sudodevjay/esp32p10display/ftdiuarttottl.png

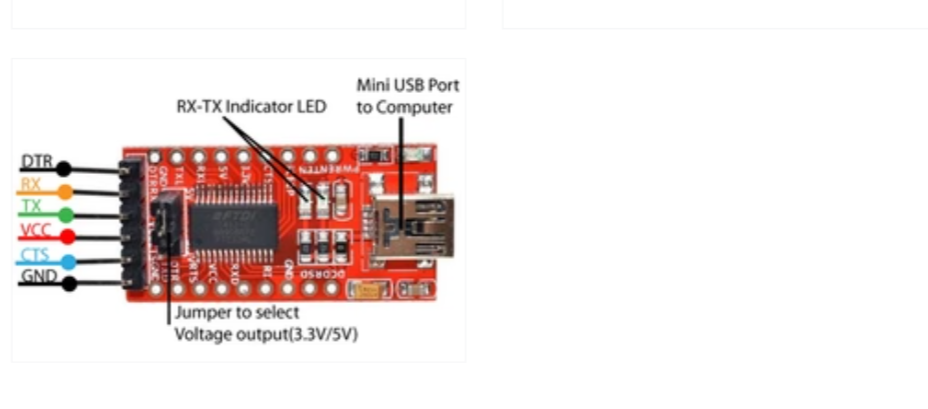
ftdiuarttottl.png
