sudodevjay/esp32p10display/Project Outputs for esp32p10displayProject/Reports/esp32p10displayPCB1.html

Altium

# Design Rule Verification Report

Date: | | 23-10-2026
Time: | | 10:41:11
Elapsed Time: | | 00:00:02
Filename: | | C:\Users\Public\Documents\Altium\esp32p10displayProject\esp32p10displayPCB1.PcbDoc

Warnings: | | 0
Rule Violations: | | 45

## Summary

Warnings | Count
Total | 0

Rule Violations | Count
Clearance Constraint (Gap=10mil) (All),(All) | 0
Clearance Constraint (Gap=8mil) (InComponent('U7')),(InComponent('U7')) | 0
Short-Circuit Constraint (Allowed=No) (All),(All) | 0
Un-Routed Net Constraint ( (All) ) | 0
Modified Polygon (Allow modified: No), (Allow shelved: No) | 0
Width Constraint (Min=6mil) (Max=50mil) (Preferred=10mil) (All) | 0
Routing Topology Rule(Topology=Shortest) (All) | 0
Power Plane Connect Rule(Relief Connect )(Expansion=20mil) (Conductor Width=10mil) (Air Gap=10mil) (Entries=4) (All) | 0
Hole Size Constraint (Min=1mil) (Max=150mil) (All) | 0
Hole To Hole Clearance (Gap=10mil) (All),(All) | 0
Minimum Solder Mask Sliver (Gap=4mil) (All),(All) | 44
Silk To Solder Mask (Clearance=4mil) (IsPad),(All) | 1
Silk to Silk (Clearance=10mil) (All),(All) | 0
Net Antennae (Tolerance=0mil) (All) | 0
Height Constraint (Min=0mil) (Max=1000mil) (Prefered=500mil) (All) | 0
Total | 45

Minimum Solder Mask Sliver (Gap=4mil) (All),(All)

Minimum Solder Mask Sliver Constraint: (3.661mil < 4mil) Between Pad U7-1(1285.433mil,1202.268mil) on Top Layer And Pad U7-2(1285.433mil,1182.583mil) on Top Layer [Top Solder] Mask Sliver [3.661mil]

Minimum Solder Mask Sliver Constraint: (3.662mil < 4mil) Between Pad U7-10(1285.433mil,1025.102mil) on Top Layer And Pad U7-11(1285.433mil,1005.417mil) on Top Layer [Top Solder] Mask Sliver [3.662mil]

Minimum Solder Mask Sliver Constraint: (3.661mil < 4mil) Between Pad U7-10(1285.433mil,1025.102mil) on Top Layer And Pad U7-9(1285.433mil,1044.787mil) on Top Layer [Top Solder] Mask Sliver [3.661mil]

Minimum Solder Mask Sliver Constraint: (3.661mil < 4mil) Between Pad U7-11(1285.433mil,1005.417mil) on Top Layer And Pad U7-12(1285.433mil,985.732mil) on Top Layer [Top Solder] Mask Sliver [3.661mil]

Minimum Solder Mask Sliver Constraint: (3.661mil < 4mil) Between Pad U7-13(1341.732mil,929.433mil) on Top Layer And Pad U7-14(1361.417mil,929.433mil) on Top Layer [Top Solder] Mask Sliver [3.661mil]

Minimum Solder Mask Sliver Constraint: (3.662mil < 4mil) Between Pad U7-14(1361.417mil,929.433mil) on Top Layer And Pad U7-15(1381.102mil,929.433mil) on Top Layer [Top Solder] Mask Sliver [3.662mil]

Minimum Solder Mask Sliver Constraint: (3.661mil < 4mil) Between Pad U7-15(1381.102mil,929.433mil) on Top Layer And Pad U7-16(1400.787mil,929.433mil) on Top Layer [Top Solder] Mask Sliver [3.661mil]

Minimum Solder Mask Sliver Constraint: (3.661mil < 4mil) Between Pad U7-16(1400.787mil,929.433mil) on Top Layer And Pad U7-17(1420.472mil,929.433mil) on Top Layer [Top Solder] Mask Sliver [3.661mil]

Minimum Solder Mask Sliver Constraint: (3.662mil < 4mil) Between Pad U7-17(1420.472mil,929.433mil) on Top Layer And Pad U7-18(1440.158mil,929.433mil) on Top Layer [Top Solder] Mask Sliver [3.662mil]

Minimum Solder Mask Sliver Constraint: (3.661mil < 4mil) Between Pad U7-18(1440.158mil,929.433mil) on Top Layer And Pad U7-19(1459.842mil,929.433mil) on Top Layer [Top Solder] Mask Sliver [3.661mil]

Minimum Solder Mask Sliver Constraint: (3.662mil < 4mil) Between Pad U7-19(1459.842mil,929.433mil) on Top Layer And Pad U7-20(1479.528mil,929.433mil) on Top Layer [Top Solder] Mask Sliver [3.662mil]

Minimum Solder Mask Sliver Constraint: (3.662mil < 4mil) Between Pad U7-2(1285.433mil,1182.583mil) on Top Layer And Pad U7-3(1285.433mil,1162.898mil) on Top Layer [Top Solder] Mask Sliver [3.662mil]

Minimum Solder Mask Sliver Constraint: (3.661mil < 4mil) Between Pad U7-20(1479.528mil,929.433mil) on Top Layer And Pad U7-21(1499.213mil,929.433mil) on Top Layer [Top Solder] Mask Sliver [3.661mil]

Minimum Solder Mask Sliver Constraint: (3.661mil < 4mil) Between Pad U7-21(1499.213mil,929.433mil) on Top Layer And Pad U7-22(1518.898mil,929.433mil) on Top Layer [Top Solder] Mask Sliver [3.661mil]

Minimum Solder Mask Sliver Constraint: (3.662mil < 4mil) Between Pad U7-22(1518.898mil,929.433mil) on Top Layer And Pad U7-23(1538.583mil,929.433mil) on Top Layer [Top Solder] Mask Sliver [3.662mil]

Minimum Solder Mask Sliver Constraint: (3.661mil < 4mil) Between Pad U7-23(1538.583mil,929.433mil) on Top Layer And Pad U7-24(1558.268mil,929.433mil) on Top Layer [Top Solder] Mask Sliver [3.661mil]

Minimum Solder Mask Sliver Constraint: (3.661mil < 4mil) Between Pad U7-25(1614.567mil,985.732mil) on Top Layer And Pad U7-26(1614.567mil,1005.417mil) on Top Layer [Top Solder] Mask Sliver [3.661mil]

Minimum Solder Mask Sliver Constraint: (3.662mil < 4mil) Between Pad U7-26(1614.567mil,1005.417mil) on Top Layer And Pad U7-27(1614.567mil,1025.102mil) on Top Layer [Top Solder] Mask Sliver [3.662mil]

Minimum Solder Mask Sliver Constraint: (3.661mil < 4mil) Between Pad U7-27(1614.567mil,1025.102mil) on Top Layer And Pad U7-28(1614.567mil,1044.787mil) on Top Layer [Top Solder] Mask Sliver [3.661mil]

Minimum Solder Mask Sliver Constraint: (3.661mil < 4mil) Between Pad U7-28(1614.567mil,1044.787mil) on Top Layer And Pad U7-29(1614.567mil,1064.472mil) on Top Layer [Top Solder] Mask Sliver [3.661mil]

Minimum Solder Mask Sliver Constraint: (3.662mil < 4mil) Between Pad U7-29(1614.567mil,1064.472mil) on Top Layer And Pad U7-30(1614.567mil,1084.158mil) on Top Layer [Top Solder] Mask Sliver [3.662mil]

Minimum Solder Mask Sliver Constraint: (3.661mil < 4mil) Between Pad U7-3(1285.433mil,1162.898mil) on Top Layer And Pad U7-4(1285.433mil,1143.213mil) on Top Layer [Top Solder] Mask Sliver [3.661mil]

Minimum Solder Mask Sliver Constraint: (3.661mil < 4mil) Between Pad U7-30(1614.567mil,1084.158mil) on Top Layer And Pad U7-31(1614.567mil,1103.842mil) on Top Layer [Top Solder] Mask Sliver [3.661mil]

Minimum Solder Mask Sliver Constraint: (3.662mil < 4mil) Between Pad U7-31(1614.567mil,1103.842mil) on Top Layer And Pad U7-32(1614.567mil,1123.528mil) on Top Layer [Top Solder] Mask Sliver [3.662mil]

Minimum Solder Mask Sliver Constraint: (3.661mil < 4mil) Between Pad U7-32(1614.567mil,1123.528mil) on Top Layer And Pad U7-33(1614.567mil,1143.213mil) on Top Layer [Top Solder] Mask Sliver [3.661mil]

Minimum Solder Mask Sliver Constraint: (3.661mil < 4mil) Between Pad U7-33(1614.567mil,1143.213mil) on Top Layer And Pad U7-34(1614.567mil,1162.898mil) on Top Layer [Top Solder] Mask Sliver [3.661mil]

Minimum Solder Mask Sliver Constraint: (3.662mil < 4mil) Between Pad U7-34(1614.567mil,1162.898mil) on Top Layer And Pad U7-35(1614.567mil,1182.583mil) on Top Layer [Top Solder] Mask Sliver [3.662mil]

Minimum Solder Mask Sliver Constraint: (3.661mil < 4mil) Between Pad U7-35(1614.567mil,1182.583mil) on Top Layer And Pad U7-36(1614.567mil,1202.268mil) on Top Layer [Top Solder] Mask Sliver [3.661mil]

Minimum Solder Mask Sliver Constraint: (3.661mil < 4mil) Between Pad U7-37(1558.268mil,1258.567mil) on Top Layer And Pad U7-38(1538.583mil,1258.567mil) on Top Layer [Top Solder] Mask Sliver [3.661mil]

Minimum Solder Mask Sliver Constraint: (3.662mil < 4mil) Between Pad U7-38(1538.583mil,1258.567mil) on Top Layer And Pad U7-39(1518.898mil,1258.567mil) on Top Layer [Top Solder] Mask Sliver [3.662mil]

Minimum Solder Mask Sliver Constraint: (3.661mil < 4mil) Between Pad U7-39(1518.898mil,1258.567mil) on Top Layer And Pad U7-40(1499.213mil,1258.567mil) on Top Layer [Top Solder] Mask Sliver [3.661mil]

Minimum Solder Mask Sliver Constraint: (3.661mil < 4mil) Between Pad U7-4(1285.433mil,1143.213mil) on Top Layer And Pad U7-5(1285.433mil,1123.528mil) on Top Layer [Top Solder] Mask Sliver [3.661mil]

Minimum Solder Mask Sliver Constraint: (3.661mil < 4mil) Between Pad U7-40(1499.213mil,1258.567mil) on Top Layer And Pad U7-41(1479.528mil,1258.567mil) on Top Layer [Top Solder] Mask Sliver [3.661mil]

Minimum Solder Mask Sliver Constraint: (3.662mil < 4mil) Between Pad U7-41(1479.528mil,1258.567mil) on Top Layer And Pad U7-42(1459.842mil,1258.567mil) on Top Layer [Top Solder] Mask Sliver [3.662mil]

Minimum Solder Mask Sliver Constraint: (3.661mil < 4mil) Between Pad U7-42(1459.842mil,1258.567mil) on Top Layer And Pad U7-43(1440.158mil,1258.567mil) on Top Layer [Top Solder] Mask Sliver [3.661mil]

Minimum Solder Mask Sliver Constraint: (3.662mil < 4mil) Between Pad U7-43(1440.158mil,1258.567mil) on Top Layer And Pad U7-44(1420.472mil,1258.567mil) on Top Layer [Top Solder] Mask Sliver [3.662mil]

Minimum Solder Mask Sliver Constraint: (3.661mil < 4mil) Between Pad U7-44(1420.472mil,1258.567mil) on Top Layer And Pad U7-45(1400.787mil,1258.567mil) on Top Layer [Top Solder] Mask Sliver [3.661mil]

Minimum Solder Mask Sliver Constraint: (3.661mil < 4mil) Between Pad U7-45(1400.787mil,1258.567mil) on Top Layer And Pad U7-46(1381.102mil,1258.567mil) on Top Layer [Top Solder] Mask Sliver [3.661mil]

Minimum Solder Mask Sliver Constraint: (3.662mil < 4mil) Between Pad U7-46(1381.102mil,1258.567mil) on Top Layer And Pad U7-47(1361.417mil,1258.567mil) on Top Layer [Top Solder] Mask Sliver [3.662mil]

Minimum Solder Mask Sliver Constraint: (3.661mil < 4mil) Between Pad U7-47(1361.417mil,1258.567mil) on Top Layer And Pad U7-48(1341.732mil,1258.567mil) on Top Layer [Top Solder] Mask Sliver [3.661mil]

Minimum Solder Mask Sliver Constraint: (3.662mil < 4mil) Between Pad U7-5(1285.433mil,1123.528mil) on Top Layer And Pad U7-6(1285.433mil,1103.842mil) on Top Layer [Top Solder] Mask Sliver [3.662mil]

Minimum Solder Mask Sliver Constraint: (3.661mil < 4mil) Between Pad U7-6(1285.433mil,1103.842mil) on Top Layer And Pad U7-7(1285.433mil,1084.158mil) on Top Layer [Top Solder] Mask Sliver [3.661mil]

Minimum Solder Mask Sliver Constraint: (3.662mil < 4mil) Between Pad U7-7(1285.433mil,1084.158mil) on Top Layer And Pad U7-8(1285.433mil,1064.472mil) on Top Layer [Top Solder] Mask Sliver [3.662mil]

Minimum Solder Mask Sliver Constraint: (3.661mil < 4mil) Between Pad U7-8(1285.433mil,1064.472mil) on Top Layer And Pad U7-9(1285.433mil,1044.787mil) on Top Layer [Top Solder] Mask Sliver [3.661mil]

Back to top

Silk To Solder Mask (Clearance=4mil) (IsPad),(All)

Silk To Solder Mask Clearance Constraint: (Collision < 4mil) Between Arc (2597.598mil,1200.575mil) on Top Overlay And Pad R34-2(2600mil,1190.26mil) on Top Layer [Top Overlay] to [Top Solder] clearance [0mil]

Back to top
