sudodevjay/esp32p10display/Project Outputs for esp32p10displayProject/Renders/render_top.png

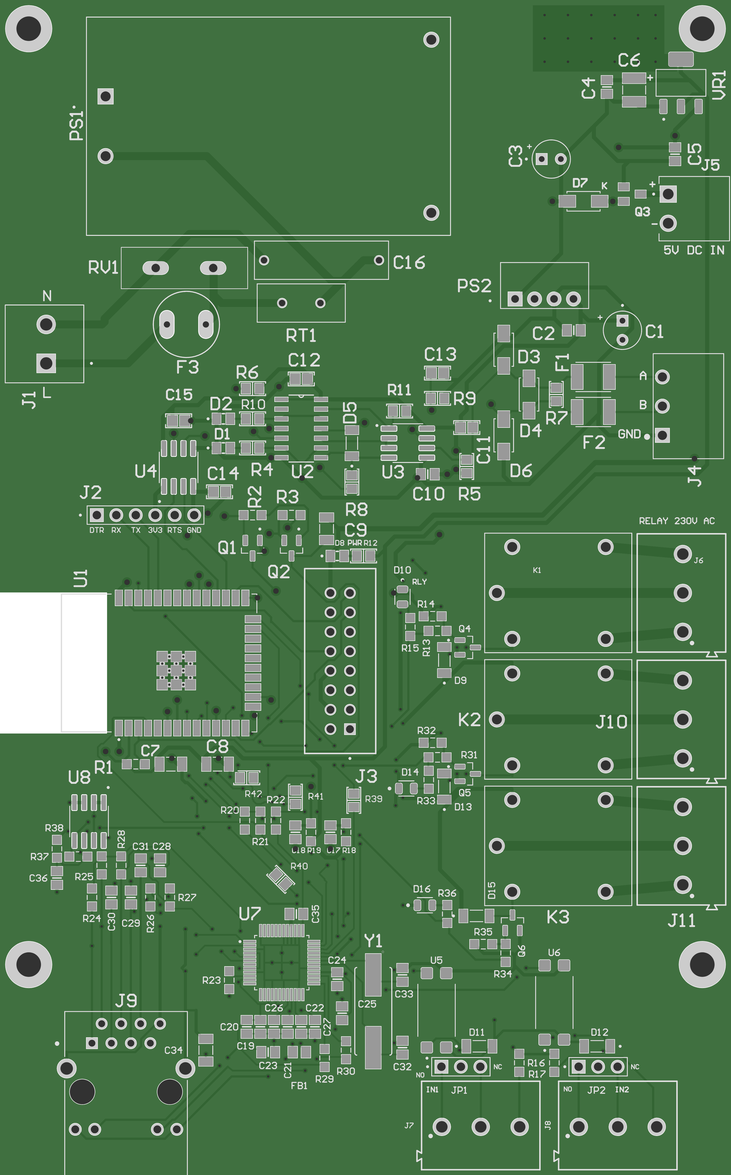
Project Outputs for esp32p10displayProject/Renders/render_top.png
