sudodevjay/esp32p10display/Project Outputs for esp32p10displayProject/Simulation/lan.png

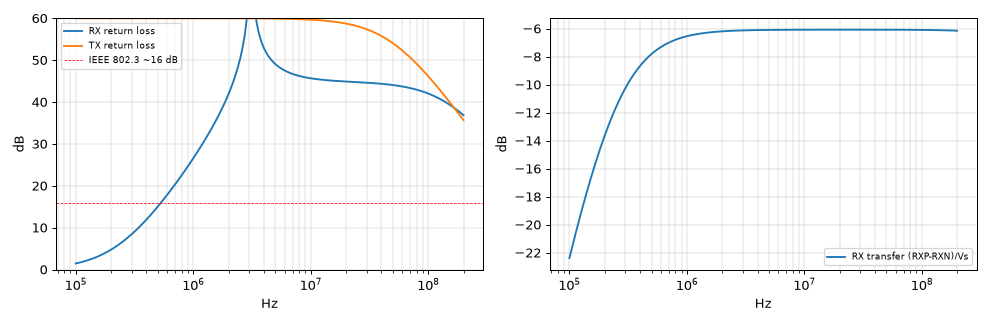
Project Outputs for esp32p10displayProject/Simulation/lan.png
