sudodevjay/esp32p10display/Project Outputs for esp32p10displayProject/Simulation/relay.png

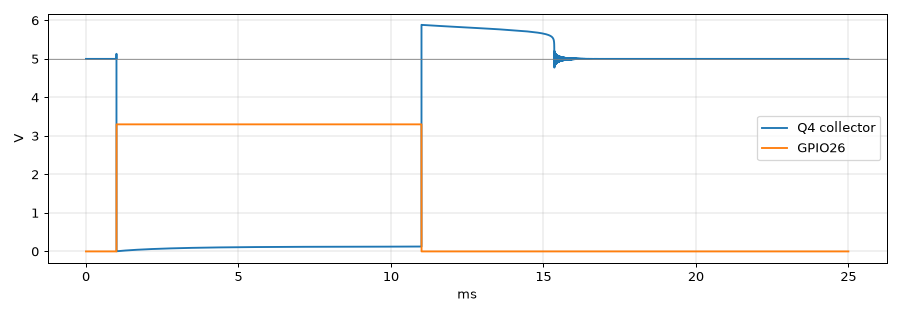
Project Outputs for esp32p10displayProject/Simulation/relay.png
