sudodevjay/esp32p10display/Project Outputs for esp32p10displayProject/Simulation/rs485.png

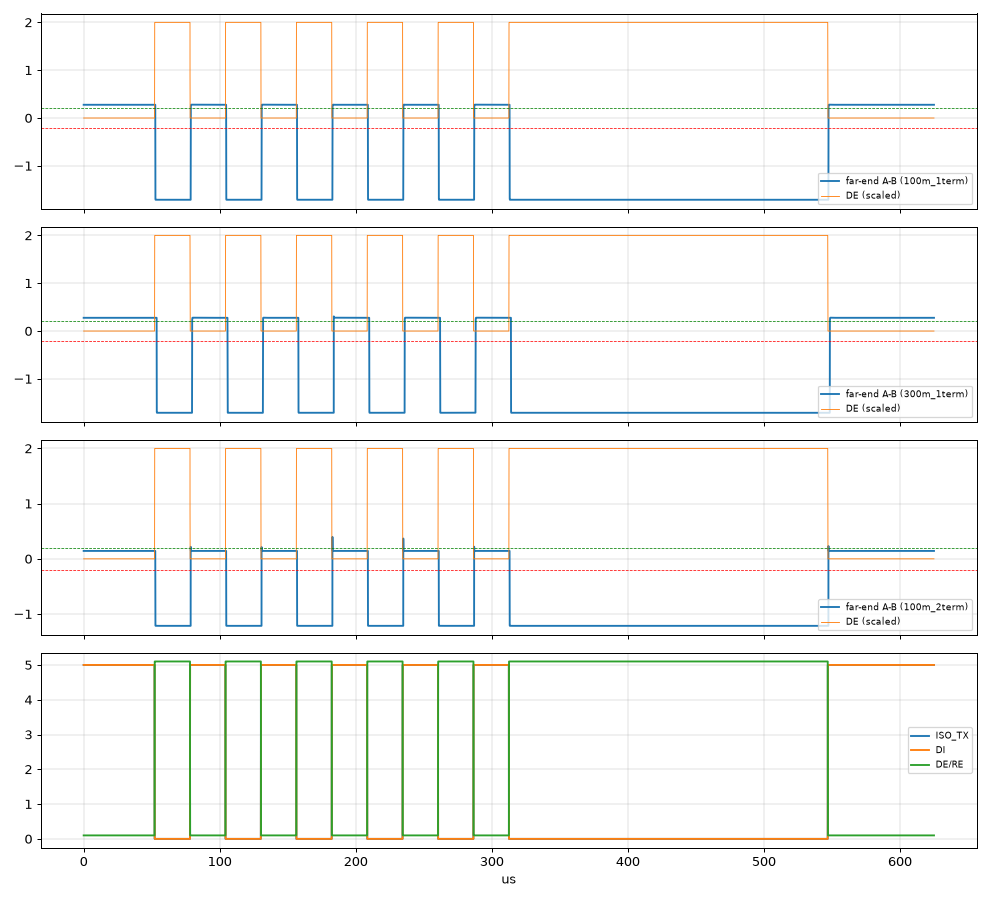
Project Outputs for esp32p10displayProject/Simulation/rs485.png
