sudodevjay/esp32p10display/Project Outputs for esp32p10displayProject/Simulation/spi_100.png

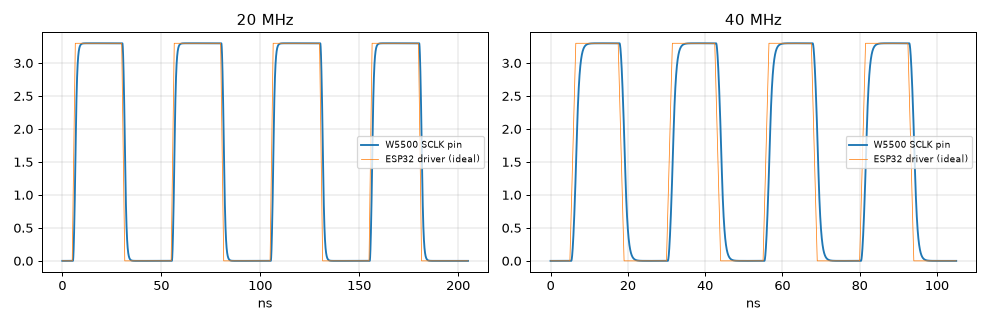
Project Outputs for esp32p10displayProject/Simulation/spi_100.png
