sudodevjay/esp32p10display/Screenshot 2026-10-12 171304.png

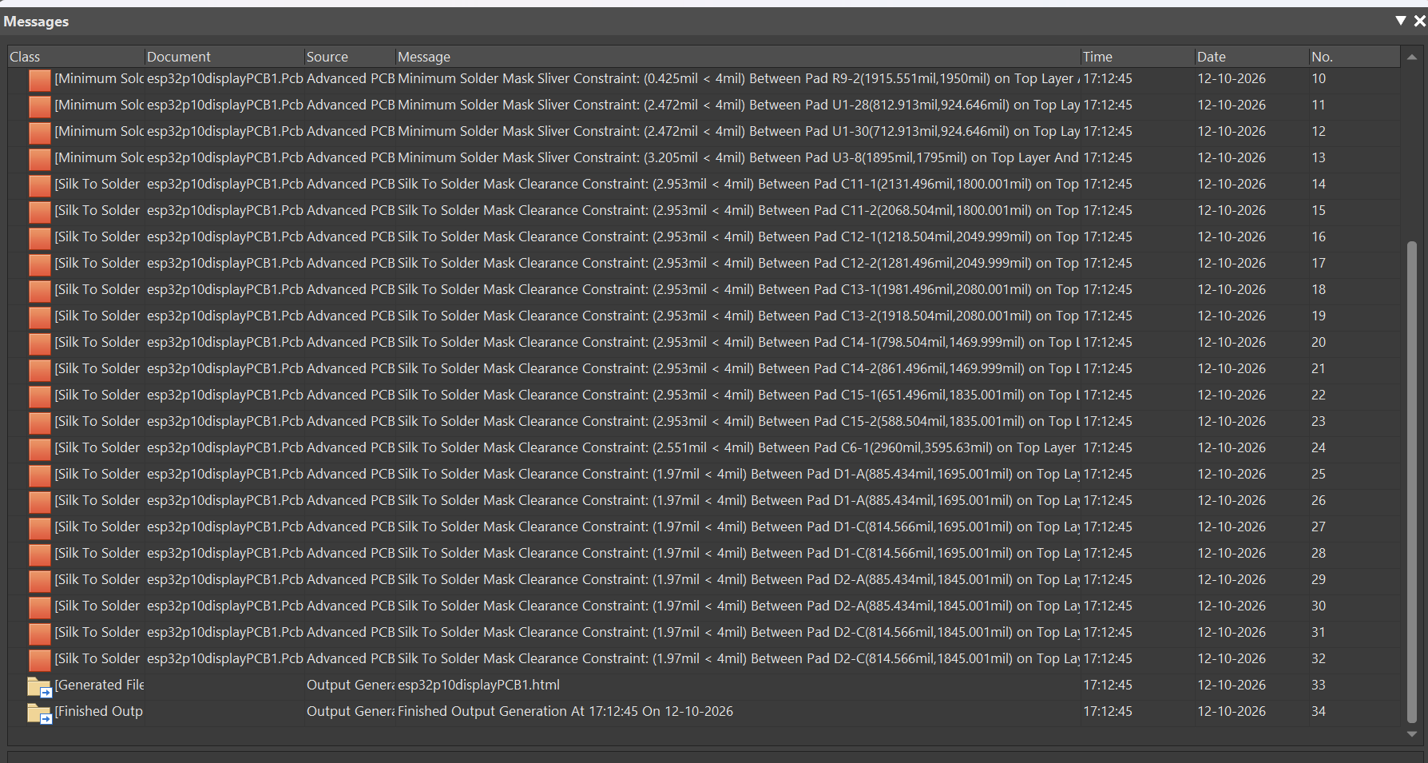
Screenshot 2026-10-12 171304.png
