sudodevjay/esp32p10display/Project Outputs for esp32p10displayProject/Sourcing/purchase_report_2026-10-23.pdf

# Purchase report: esp32p10displayProject

Boards: 5 | Suppliers searched: lcsc | 1 USD = 94.82 INR | Generated 2026-10-23 07:27
Parts total (cheapest per line, excl. shipping/GST): Rs 11765.01 | Lines not found: 23 |

## Per supplier (upload the cart file on that site)

Supplier | Lines | Total INR | Cart file
lcsc | 40 | 11765.01 | cart_lcsc_2026-10-23.csv

## Lines

Designators | MPN | Need | Supplier | SKU | Match | Buy | Unit INR | Total INR
C1 | ECEA1EN100UI | 6 | - | -
C2, C4, C5 | CL21B104KCFNNNE | 17 | lcsc | C28233 (https://www.lcsc.com/product-detail/multilayer-ceramic-capacitors-mlcc-smd-smt_samsung-electro-mechanics-cl21b104kcfnnne_C28233.html) | exact | 17 | 2.34 | 39.81
C3 | ECA-1CM101 | 6 | - | -
C6 | TAJB106K016RNJ | 6 | lcsc | C7193 (https://www.lcsc.com/product-detail/tantalum-capacitors_kyocera-avx-tajb106k016rnj_C7193.html) | exact | 6 | 18.38 | 110.26
C7 | GRM31CR71C106KAC7L | 6 | - | -
C8 | C1206C104K5RACTU | 6 | lcsc | C41430990 | exact | 6 | 4.39 | 26.34
C9 | C1206C105K5RACTU | 6 | lcsc | C2167287 (https://www.lcsc.com/product-detail/multilayer-ceramic-capacitors-mlcc-smd-smt_kemet-c1206c105k5ractu_C2167287.html) | exact | 6 | 11.31 | 67.87
C10, C17, C18, C19, C20, C21, C22, C24, C35, C36 | CL21B104KCFNNNE | 55 | lcsc | C28233 (https://www.lcsc.com/product-detail/multilayer-ceramic-capacitors-mlcc-smd-smt_samsung-electro-mechanics-cl21b104kcfnnne_C28233.html) | exact | 55 | 2.34 | 128.81
C11, C13 | C0805C102F3HACAUTO | 11 | - | -
C12, C14, C15 | CL21B104KCFNNNE | 17 | lcsc | C28233 (https://www.lcsc.com/product-detail/multilayer-ceramic-capacitors-mlcc-smd-smt_samsung-electro-mechanics-cl21b104kcfnnne_C28233.html) | exact | 17 | 2.34 | 39.81
C16 | ECQUAAF104M | 6 | - | -
C23, C25 | CL21A106KOQNNNE | 11 | lcsc | C1713 (https://www.lcsc.com/product-detail/multilayer-ceramic-capacitors-mlcc-smd-smt_samsung-electro-mechanics-cl21a106koqnnne_C1713.html) | exact | 11 | 3.75 | 41.30
C26 | CL21A475KAQNNNE | 6 | lcsc | C1779 (https://www.lcsc.com/product-detail/multilayer-ceramic-capacitors-mlcc-smd-smt_samsung-electro-mechanics-cl21a475kaqnnne_C1779.html) | exact | 6 | 3.65 | 21.90
C27, C29 | CL21B103KBANNNC | 11 | lcsc | C1710 (https://www.lcsc.com/product-detail/multilayer-ceramic-capacitors-mlcc-smd-smt_samsung-electro-mechanics-cl21b103kbannnc_C1710.html) | exact | 11 | 0.87 | 9.60
C28 | CL21B223KBANNNC | 6 | lcsc | C1729 (https://www.lcsc.com/product-detail/multilayer-ceramic-capacitors-mlcc-smd-smt_samsung-electro-mechanics-cl21b223kbannnc_C1729.html) | exact | 6 | 0.80 | 4.78
C30, C31 | CL21B682KBANNNC | 11 | - | -
C32, C33 | CL21C270JBANNNC | 11 | - | -
C34 | C1206C102KGRACAUTO | 6 | lcsc | C600002 (https://www.lcsc.com/product-detail/multilayer-ceramic-capacitors-mlcc-smd-smt_kemet-c1206c102kgracauto_C600002.html) | exact | 6 | 24.52 | 147.12
D1, D2, D8 | 597-3305-607F | 17 | - | -
D3, D4, D6 | SMAJ7.5CA | 17 | lcsc | C908813 (https://www.lcsc.com/product-detail/esd-and-surge-protection-tvs-esd_goodwork-smaj7-5ca_C908813.html) | exact | 17 | 3.00 | 50.94
D5, D9, D11, D12, D13, D15 | LL4148_L1G | 33 | lcsc | C49284670 | partial | 33 | 0.62 | 20.34
D7 | SMAJ5.0A | 6 | lcsc | C353442 (https://www.lcsc.com/product-detail/esd-and-surge-protection-tvs-esd_shandong-jingdao-microelectronics-smaj5-0a_C353442.html) | exact | 6 | 3.17 | 19.00
D10, D14, D16 | APT2012SRCPRV | 17 | - | -
F1, F2 | MF-MSMF010-2 | 11 | lcsc | C12430 (https://www.lcsc.com/product-detail/resettable-fuses_bourns-mf-msmf010-2_C12430.html) | exact | 11 | 6.38 | 70.20
F3 | TR5 | 6 | - | -
FB1 | MPZ2012S102AT000 | 6 | lcsc | C76817 (https://www.lcsc.com/product-detail/ferrite-beads_tdk-mpz2012s102at000_C76817.html) | exact | 6 | 3.32 | 19.91
J1 | TB007-508-02BE | 6 | lcsc | C3816270 (https://www.lcsc.com/product-detail/screw-terminal-blocks_cui-tb007-508-02be_C3816270.html) | exact | 6 | 48.85 | 293.11
J2 | 68604-406HLF | 6 | - | -

J3 | TSS-108-01-T-D | 6 | - | -
J4 | 284513-3 | 6 | - | -
J5 | TBP02R1-381-02BE | 6 | - | -
J6, J7, J8, J10, J11 | 691236510003 | 28 | - | -
J9 | HR911105A | 6 | lcsc | C12074 (https://www.lcsc.com/product-detail/ethernet-connectors-modular-connectors-rj45-rj11_hanrun-zhongshan-hanrun-elec-hr911105a_C12074.html) | exact | 6 | 163.44 | 980.65
JP1, JP2 | 68001-403HLF | 11 | lcsc | C3334227 (https://www.lcsc.com/product-detail/pin-headers_amphenol-icc-68001-403hlf_C3334227.html) | exact | 11 | 23.52 | 258.67
K1, K2, K3 | SRD-05VDC-SL-C | 17 | lcsc | C35449 (https://www.lcsc.com/product-detail/power-relays_ningbo-songle-relay-srd-05vdc-sl-c_C35449.html) | exact | 17 | 32.72 | 556.28
PS1 | HLK-10M05 | 6 | lcsc | C403745 (https://www.lcsc.com/product-detail/ac-dc-power-modules_hi-link-hlk-10m05_C403745.html) | exact | 6 | 338.83 | 2032.98
PS2 | RFM-0505S | 6 | lcsc | C49231035 | exact | 6 | 154.77 | 928.59
Q1, Q2, Q4, Q5, Q6 | BC848C RFG | 28 | lcsc | C2926213 (https://www.lcsc.com/product-detail/bipolar-bjt_fosan-bc848c_C2926213.html) | partial | 28 | 0.86 | 24.16
Q3 | SI2301CDS-T1-GE3 | 6 | lcsc | C10487 (https://www.lcsc.com/product-detail/mosfets_vishay-intertech-si2301cds-t1-ge3_C10487.html) | exact | 6 | 8.89 | 53.36
R1, R2, R3, R14, R18, R19, R20, R21, R22, R32, R35 | ERA6VRB1002V | 61 | - | -
R4, R10 | CRCW0805330RFKEAHP | 11 | lcsc | C313892 (https://www.lcsc.com/product-detail/chip-resistor-surface-mount_vishay-intertech-crcw0805330rfkeahp_C313892.html) | exact | 11 | 8.10 | 89.07
R5, R9 | CPF0805B470RE | 11 | - | -
R6, R7, R11 | CPF0805B10KE | 17 | lcsc | C6155611 (https://www.lcsc.com/product-detail/chip-resistor-surface-mount_te-connectivity-cpf0805b10ke_C6155611.html) | exact | 17 | 21.45 | 364.62
R8 | CPF0805B1K0E | 6 | - | -
R12 | CRCW0805150RFKEAHP | 6 | lcsc | C313835 (https://www.lcsc.com/product-detail/chip-resistor-surface-mount_vishay-intertech-crcw0805150rfkeahp_C313835.html) | exact | 6 | 5.73 | 34.36
R13, R15, R16, R17, R31, R33, R34, R36 | ERA6VRB1001V | 44 | - | -
R23 | ERJ-6ENF1242V | 6 | - | -
R24, R25, R26, R27 | ERJ-6ENF49R9V | 22 | - | -
R28 | ERJ-6ENF10R0V | 6 | lcsc | C193989 (https://www.lcsc.com/product-detail/chip-resistor-surface-mount_panasonic-erj6enf10r0v_C193989.html) | exact | 6 | 2.82 | 16.90
R29, R30 | ERJ-6ENF3300V | 11 | lcsc | C410007 (https://www.lcsc.com/product-detail/chip-resistor-surface-mount_panasonic-erj6enf3300v_C410007.html) | exact | 11 | 0.76 | 8.34
R37, R38 | ERA6VRB4701V | 11 | - | -
R39, R40, R41, R42 | RC0805FR-0747RL | 22 | lcsc | C114541 (https://www.lcsc.com/product-detail/chip-resistor-surface-mount_yageo-rc0805fr-0747rl_C114541.html) | exact | 22 | 1.85 | 40.68
RT1 | B57236S0509M000 | 6 | lcsc | C3761585 (https://www.lcsc.com/product-detail/resettable-fuses_tdk-b57236s0509m000_C3761585.html) | exact | 6 | 13.90 | 83.40
RV1 | MOV-14D471K | 6 | lcsc | C1527439 (https://www.lcsc.com/product-detail/varistors_bourns-mov-14d471k_C1527439.html) | exact | 6 | 42.49 | 254.93
U1 | ESP32-WROOM-32 | 6 | lcsc | C701341 (https://www.lcsc.com/product-detail/wifi-modules_espressif-systems-esp32-wroom-32e-n4_C701341.html) | partial | 6 | 356.19 | 2137.15
U2 | 74HC14D | 6 | lcsc | C52140397 | exact | 6 | 13.29 | 79.76
U3 | SN65176BDR | 6 | lcsc | C31302 (https://www.lcsc.com/product-detail/rs-485-rs-422-ics_texas-instruments-sn65176bdr_C31302.html) | exact | 6 | 28.72 | 172.33
U4 | ADUM1201CR | 6 | lcsc | C54423133 | partial | 6 | 58.15 | 348.92
U5, U6 | EL817S1(A)(TU)-V | 11 | lcsc | C17362267 (https://www.lcsc.com/product-detail/transistor-photovoltaic-output-optoisolators_everlight-elec-el817s1-a-tu-v_C17362267.html) | exact | 11 | 11.22 | 123.39
U7 | W5500 | 6 | lcsc | C32843 (https://lcsc.com/product-detail/ethernet-controllers_wiznet-w5500_C32843.html) | exact | 6 | 268.11 | 1608.68
U8 | AT24C512C-SSHM-T | 6 | lcsc | C54668 (https://www.lcsc.com/product-detail/eeprom_microchip-tech-at24c512c-sshm-t_C54668.html) | exact | 6 | 52.57 | 315.41
VR1 | LM1117IMPX-3.3/NOPB | 6 | lcsc | C23984 (https://www.lcsc.com/product-detail/voltage-regulators-linear-low-drop-out-ldo-regulators_texas-instruments-lm1117impx-3-3-nopb_C23984.html) | exact | 6 | 23.54 | 141.26
Y1 | ECS-250-18-5PX-TR | 6 | - | -

"partial" = supplier part number only starts with / extends the BOM MPN (packaging or suffix variant): check before ordering. Red lines were not found with stock: choose a part manually. Shipping, customs and GST are not included.
