sudodevjay/esp32p10display/Project Outputs for esp32p10displayProject/Sourcing/purchase_report_2026-10-14.pdf

# Purchase report: esp32p10displayProject

Boards: 5 | Suppliers searched: lcsc | 1 USD = 95.28 INR | Generated 2026-10-14 15:44
Parts total (cheapest per line, excl. shipping/GST): Rs 7513.35 | Lines not found: 13 |

## Per supplier (upload the cart file on that site)

Supplier | Lines | Total INR | Cart file
lcsc | 25 | 7513.35 | cart_lcsc_2026-10-14.csv

## Lines

Designators | MPN | Need | Supplier | SKU | Match | Buy | Unit INR | Total INR
C1 | ECEA1EN100UI | 6 | - | -
C2, C4, C5 | CL21B104KCFNNNE | 17 | lcsc | C28233 (https://www.lcsc.com/product-detail/multilayer-ceramic-capacitors-mlcc-smd-smt_samsung-electro-mechanics-cl21b104kcfnnne_C28233.html) | exact | 17 | 3.17 | 53.94
C3 | ECA-1CM101 | 6 | - | -
C6 | TAJB106K016RNJ | 6 | lcsc | C7193 (https://www.lcsc.com/product-detail/tantalum-capacitors_kyocera-avx-tajb106k016rnj_C7193.html) | exact | 6 | 18.73 | 112.39
C7 | GRM31CR71C106KAC7L | 6 | - | -
C8 | C1206C104K5RACTU | 6 | lcsc | C41430990 | exact | 6 | 4.40 | 26.41
C9 | C1206C105K5RACTU | 6 | lcsc | C2167287 (https://www.lcsc.com/product-detail/multilayer-ceramic-capacitors-mlcc-smd-smt_kemet-c1206c105k5ractu_C2167287.html) | exact | 6 | 9.87 | 59.23
C10 | CL21B104KCFNNNE | 6 | lcsc | C28233 (https://www.lcsc.com/product-detail/multilayer-ceramic-capacitors-mlcc-smd-smt_samsung-electro-mechanics-cl21b104kcfnnne_C28233.html) | exact | 6 | 3.17 | 19.04
C11, C13 | C0805C102F3HACAUTO | 11 | - | -
C12, C14, C15 | CL21B104KCFNNNE | 17 | lcsc | C28233 (https://www.lcsc.com/product-detail/multilayer-ceramic-capacitors-mlcc-smd-smt_samsung-electro-mechanics-cl21b104kcfnnne_C28233.html) | exact | 17 | 3.17 | 53.94
C16 | ECQUAAF104M | 6 | - | -
D1, D2, D8 | 597-3305-607F | 17 | - | -
D3, D4, D6 | SMAJ7.5CA | 17 | lcsc | C908813 (https://www.lcsc.com/product-detail/esd-and-surge-protection-tvs-esd_goodwork-smaj7-5ca_C908813.html) | exact | 17 | 3.00 | 51.02
D5 | LL4148_L1G | 6 | lcsc | C571356 (https://www.lcsc.com/product-detail/switching-diodes_high-diode-ll4148_C571356.html) | partial | 6 | 0.67 | 4.00
D7 | SMAJ5.0A | 6 | lcsc | C353442 (https://www.lcsc.com/product-detail/esd-and-surge-protection-tvs-esd_shandong-jingdao-microelectronics-smaj5-0a_C353442.html) | exact | 6 | 3.17 | 19.04
F1, F2 | MF-MSMF010-2 | 11 | lcsc | C12430 (https://www.lcsc.com/product-detail/resettable-fuses_bourns-mf-msmf010-2_C12430.html) | exact | 11 | 6.55 | 72.00
F3 | TR5 | 6 | - | -
J1 | TB007-508-02BE | 6 | lcsc | C3816270 (https://www.lcsc.com/product-detail/screw-terminal-blocks_cui-tb007-508-02be_C3816270.html) | exact | 6 | 48.96 | 293.79
J2 | 68604-406HLF | 6 | - | -
J3 | TSS-108-01-T-D | 6 | - | -
J4 | 284513-3 | 6 | - | -
J5 | TBP02R1-381-02BE | 6 | - | -
PS1 | HLK-10M05 | 6 | lcsc | C403745 (https://www.lcsc.com/product-detail/ac-dc-power-modules_hi-link-hlk-10m05_C403745.html) | exact | 6 | 339.63 | 2037.75
PS2 | RFM-0505S | 6 | lcsc | C49231035 | exact | 6 | 155.13 | 930.75
Q1, Q2 | BC848C RFG | 11 | lcsc | C2926213 (https://www.lcsc.com/product-detail/bipolar-bjt_fosan-bc848c_C2926213.html) | partial | 11 | 0.86 | 9.43
Q3 | SI2301CDS-T1-GE3 | 6 | lcsc | C10487 (https://www.lcsc.com/product-detail/mosfets_vishay-intertech-si2301cds-t1-ge3_C10487.html) | exact | 6 | 9.32 | 55.91
R1, R2, R3 | ERA6VRB1002V | 17 | - | -
R4, R10 | CRCW0805330RFKEAHP | 11 | lcsc | C313892 (https://www.lcsc.com/product-detail/chip-resistor-surface-mount_vishay-intertech-crcw0805330rfkeahp_C313892.html) | exact | 11 | 8.12 | 89.30
R5, R8, R9 | CPF0805B1K0E | 17 | - | -
R6, R7, R11 | CPF0805B10KE | 17 | lcsc | C6155611 (https://www.lcsc.com/product-detail/chip-resistor-surface-mount_te-connectivity-cpf0805b10ke_C6155611.html) | exact | 17 | 21.50 | 365.58

R12 | CRCW0805150RFKEAHP | 6 | lcsc | C313835 (https://www.lcsc.com/product-detail/chip-resistor-surface-mount_vishay-intertech-crcw0805150rfkeahp_C313835.html) | exact | 6 | 5.74 | 34.42
RT1 | B57236S0509M000 | 6 | lcsc | C3761585 (https://www.lcsc.com/product-detail/resettable-fuses_tdk-b57236s0509m000_C3761585.html) | exact | 6 | 13.93 | 83.58
RV1 | MOV-14D471K | 6 | lcsc | C1527439 (https://www.lcsc.com/product-detail/varistors_bourns-mov-14d471k_C1527439.html) | exact | 6 | 42.59 | 255.54
U1 | ESP32-WROOM-32 | 6 | lcsc | C701341 (https://www.lcsc.com/product-detail/wifi-modules_espressif-systems-esp32-wroom-32e-n4_C701341.html) | partial | 6 | 357.03 | 2142.20
U2 | 74HC14D | 6 | lcsc | C52140397 | exact | 6 | 13.33 | 79.98
U3 | SN65176BDR | 6 | lcsc | C31302 (https://www.lcsc.com/product-detail/rs-485-rs-422-ics_texas-instruments-sn65176bdr_C31302.html) | exact | 6 | 28.79 | 172.76
U4 | ADUM1201CR | 6 | lcsc | C54423133 | partial | 6 | 58.29 | 349.75
VR1 | LM1117IMPX-3.3/NOPB | 6 | lcsc | C23984 (https://www.lcsc.com/product-detail/voltage-regulators-linear-low-drop-out-ldo-regulators_texas-instruments-lm1117impx-3-3-nopb_C23984.html) | exact | 6 | 23.60 | 141.61

"partial" = supplier part number only starts with / extends the BOM MPN (packaging or suffix variant): check before ordering. Red lines were not found with stock: choose a part manually. Shipping, customs and GST are not included.
