sudodevjay/esp32p10display/Order_Files/Component_Order_List.xlsx

Sheet: Order list
Sr | Component | Designators | Pieces per board | Part number (as bought) | Website | Quantity (in cart) | Price per piece (Rs) | Overall price (Rs) = qty x price | Price basis | Note
1 | Resistor 10k 0805 1% | R1,R2,R3 | 3 | RC0805FR-0710KL | Sharvi Electronics | 20 | Rs 0.82 |  | ex-GST (18% GST extra) | ESP32 EN pull-up + auto-reset bases; min order 20
2 | Resistor 150R 0805 1% | R12 | 1 | RC0805FR-07150RL | Sharvi Electronics | 20 | Rs 0.82 |  | ex-GST (18% GST extra) | PWR LED resistor; min order 20
3 | Capacitor 100nF 100V 0805 | C4,C5 | 2 | CC0805KKX7R0BB104 | Sharvi Electronics | 11 | Rs 4.76 |  | ex-GST (18% GST extra) | LM1117 in/out decoupling
4 | Capacitor 10uF 16V 1206 | C7 | 1 | 1206X106K160CT | Sharvi Electronics | 10 | Rs 3.95 |  | ex-GST (18% GST extra) | 3V3 bulk; min order 10
5 | Capacitor 1uF 16V 1206 | C9 | 1 | CC1206KKX7R7BB105 | Sharvi Electronics | 10 | Rs 2.92 |  | ex-GST (18% GST extra) | EN delay cap; min order 10
6 | Female header 2x8 2.54mm | J3 | 1 | 2X8 16Pin Female Berg Strip | Sharvi Electronics | 6 | Rs 11.92 |  | ex-GST (18% GST extra) | P10 panel connector
7 | Right-angle male header 7x1 2.54mm (use 6 pins) | J2 | 1 | 7x1 7Pin Male Right Angle | Sharvi Electronics | 6 | Rs 5.18 |  | ex-GST (18% GST extra) | FTDI programming header
8 | MOSFET P-ch SI2301 | Q3 | 1 | SI2301CDS-T1-GE3 | Sharvi Electronics | 6 | Rs 24.69 |  | ex-GST (18% GST extra) | 5V DC input reverse-polarity protection
9 | LDO 3.3V SOT-223 | VR1 | 1 | LM1117GS 3.3V | Sharvi Electronics | 6 | Rs 13.75 |  | ex-GST (18% GST extra) | Generic LM1117-3.3 instead of TI LM1117IMPX-3.3
10 | Transistor NPN SOT-23 | Q1,Q2 | 2 | BC848 30V 100mA | Sharvi Electronics | 11 | Rs 3.46 |  | ex-GST (18% GST extra) | Auto-reset / auto-boot (DTR, RTS)
11 | TVS diode 5V unidirectional | D7 | 1 | SMAJ5.0A (Littelfuse) | Robu.in | 6 | Rs 21.00 |  | incl. GST | 5V rail protection
12 | LED 0805 green (yellow-green 571nm) | D8 | 1 | LTST-C171KGKT (Lite-On) | Robu.in | 6 | Rs 2.46 |  | incl. GST | PWR LED
13 | ESP32 module | U1 | 1 | ESP32-WROOM-32 | Not on Sharvi/Robu (Balaji / other) | 6 | Rs 356.19 |  | LCSC reference price, not bought yet | LCSC C701341 (reference price)
14 | Electrolytic 100uF 16V THT 5x11 | C3 | 1 | ECA-1CM101 / ECA-1CM101I | Not on Sharvi/Robu (Balaji / other) | 6 |  |  | price not known yet | LCSC out of stock
15 | Tantalum 10uF 16V 3528 | C6 | 1 | TAJB106K016RNJ | Not on Sharvi/Robu (Balaji / other) | 6 | Rs 18.38 |  | LCSC reference price, not bought yet | LCSC C7193 (reference)
16 | Capacitor 100nF 1206 | C8 | 1 | C1206C104K5RACTU | Not on Sharvi/Robu (Balaji / other) | 6 | Rs 4.39 |  | LCSC reference price, not bought yet | LCSC C41430990 (reference)
17 | Pluggable terminal 2-pin 3.81 (5V DC in) | J5 | 1 | TBP02R1-381-02BE + plug | Not on Sharvi/Robu (Balaji / other) | 6 |  |  | price not known yet | Not found yet

Sheet: Summary
Website | Lines | Subtotal (Rs) | GST (Rs) | Total (Rs) | Note
Sharvi Electronics |  |  |  |  | Prices ex-GST; shipping extra
Robu.in |  |  | Rs 0.00 |  | Prices include GST; shipping extra
Total (Sharvi + Robu)
Not on Sharvi/Robu (Balaji / other) |  |  | Rs 0.00 |  | Reference prices only (some unknown); not in any cart
JLCPCB: the same full PCB (5 pcs, 95.5 x 153.52 mm), USD 11.10 + shipping |  |  |  |  | In JLCPCB cart; payment pending
This list is only for a P10-display-only build: ESP32 + P10 connector + 5V/3V3 power + programming/auto-reset + PWR LED.
On the full PCB leave the RS485, Ethernet, relay, input and EEPROM parts unfitted (see sheet 'Not fitted (DNP)').

Sheet: Not yet in any cart
Sr | Component | Designators | Pieces per board | Part number needed | Quantity needed (5 boards + spare) | Reference price per piece (Rs, LCSC) | Reference total (Rs) | Status / note
1 | ESP32 module | U1 | 1 | ESP32-WROOM-32 | 6 | Rs 356.19 |  | LCSC C701341 (reference price)
2 | Electrolytic 100uF 16V THT 5x11 | C3 | 1 | ECA-1CM101 / ECA-1CM101I | 6 |  |  | LCSC out of stock
3 | Tantalum 10uF 16V 3528 | C6 | 1 | TAJB106K016RNJ | 6 | Rs 18.38 |  | LCSC C7193 (reference)
4 | Capacitor 100nF 1206 | C8 | 1 | C1206C104K5RACTU | 6 | Rs 4.39 |  | LCSC C41430990 (reference)
5 | Pluggable terminal 2-pin 3.81 (5V DC in) | J5 | 1 | TBP02R1-381-02BE + plug | 6 |  |  | Not found yet

Sheet: Not fitted (DNP)
Circuit | Designators left unfitted
AC mains input (not used: board runs from an external 5V SMPS via J5) | PS1, RV1, RT1, F3, C16, J1
RS485 (isolated) | U2, U3, U4, PS2, C1, C2, C10-C15, D1-D6, F1, F2, J4, R4-R11
Ethernet (W5500) | U7, J9, Y1, FB1, C19-C35, R20-R30
Relays K1-K3 | K1, K2, K3, J6, J10, J11, Q4, Q5, Q6, D9, D10, D13-D16, R13-R15, R31-R36
Opto inputs | U5, U6, J7, J8, JP1, JP2, D11, D12, R16-R19
EEPROM | U8, R37, R38, C36
