sudodevjay/esp32p10display/Order_Files/Component_Order_List.csv

Sr | Component | Designators | Pieces per board | Part number (as bought) | Website | Quantity (in cart) | Price per piece (Rs) | Overall price (Rs) = qty x price | Price basis | Note
1 | Resistor 10k 0805 1% | R1,R2,R3 | 3 | RC0805FR-0710KL | Sharvi Electronics | 20 | 0.82 | 16.4 | ex-GST | ESP32 EN pull-up + auto-reset bases; min order 20
2 | Resistor 150R 0805 1% | R12 | 1 | RC0805FR-07150RL | Sharvi Electronics | 20 | 0.82 | 16.4 | ex-GST | PWR LED resistor; min order 20
3 | Capacitor 100nF 100V 0805 | C4,C5 | 2 | CC0805KKX7R0BB104 | Sharvi Electronics | 11 | 4.76 | 52.36 | ex-GST | LM1117 in/out decoupling
4 | Capacitor 10uF 16V 1206 | C7 | 1 | 1206X106K160CT | Sharvi Electronics | 10 | 3.95 | 39.5 | ex-GST | 3V3 bulk; min order 10
5 | Capacitor 1uF 16V 1206 | C9 | 1 | CC1206KKX7R7BB105 | Sharvi Electronics | 10 | 2.92 | 29.2 | ex-GST | EN delay cap; min order 10
6 | Varistor MOV 14D471K | RV1 | 1 | MOV-14D471K | Sharvi Electronics | 6 | 14.53 | 87.18 | ex-GST | Mains input protection
7 | Female header 2x8 2.54mm | J3 | 1 | 2X8 16Pin Female Berg Strip | Sharvi Electronics | 6 | 11.92 | 71.52 | ex-GST | P10 panel connector
8 | Right-angle male header 7x1 2.54mm (use 6 pins) | J2 | 1 | 7x1 7Pin Male Right Angle | Sharvi Electronics | 6 | 5.18 | 31.08 | ex-GST | FTDI programming header
9 | MOSFET P-ch SI2301 | Q3 | 1 | SI2301CDS-T1-GE3 | Sharvi Electronics | 6 | 24.69 | 148.14 | ex-GST | 5V DC input reverse-polarity protection
10 | LDO 3.3V SOT-223 | VR1 | 1 | LM1117GS 3.3V | Sharvi Electronics | 6 | 13.75 | 82.5 | ex-GST | Generic LM1117-3.3 instead of TI LM1117IMPX-3.3
11 | Transistor NPN SOT-23 | Q1,Q2 | 2 | BC848 30V 100mA | Sharvi Electronics | 11 | 3.46 | 38.06 | ex-GST | Auto-reset / auto-boot (DTR, RTS)
12 | 5V 10W AC-DC module | PS1 | 1 | HLK-10M05 | Robu.in | 6 | 322.0 | 1932.0 | incl. GST
13 | TVS diode 5V unidirectional | D7 | 1 | SMAJ5.0A (Littelfuse) | Robu.in | 6 | 21.0 | 126.0 | incl. GST | 5V rail protection
14 | LED 0805 green (yellow-green 571nm) | D8 | 1 | LTST-C171KGKT (Lite-On) | Robu.in | 6 | 2.27 | 13.62 | incl. GST | PWR LED
