sudodevjay/esp32p10display/Order_Files/Parts_not_yet_ordered.csv

Sr | Component | Designators | Pieces per board | Part number needed | Quantity needed (5 boards + spare) | Reference price per piece (Rs, LCSC) | Reference total (Rs) | Status / note
1 | ESP32 module | U1 | 1 | ESP32-WROOM-32 | 6 | 356.19 | 2137.14 | LCSC C701341 (reference price)
2 | Electrolytic 100uF 16V THT 5x11 | C3 | 1 | ECA-1CM101 / ECA-1CM101I | 6 |  |  | LCSC out of stock
3 | Tantalum 10uF 16V 3528 | C6 | 1 | TAJB106K016RNJ | 6 | 18.38 | 110.28 | LCSC C7193 (reference)
4 | Capacitor 100nF 1206 | C8 | 1 | C1206C104K5RACTU | 6 | 4.39 | 26.34 | LCSC C41430990 (reference)
5 | X2 capacitor 0.1uF 275VAC | C16 | 1 | ECQ-UAAF104M | 6 |  |  | Not found yet
6 | Fuse T1A 250V | F3 | 1 | TR5 (Littelfuse 372) | 6 |  |  | Not found yet
7 | NTC inrush 5R | RT1 | 1 | B57236S0509M000 | 6 | 13.9 | 83.4 | LCSC C3761585 (reference)
8 | Terminal 2-pin 5.08mm (mains in) | J1 | 1 | TB007-508-02BE | 6 | 48.85 | 293.1 | LCSC C3816270 (reference)
9 | Pluggable terminal 2-pin 3.81 (5V DC in) | J5 | 1 | TBP02R1-381-02BE + plug | 6 |  |  | Not found yet
