sudodevjay/esp32p10display/Order_Files/BOM_full.csv

# | Designators | Qty | Value / Comment | Manufacturer | Manufacturer Part No | PCB Footprint | Description | LCSC Part #
1 | C1 | 1 | CAP ELE 10µF 25V TH | Panasonic | ECEA1EN100UI | CAP ELE 10µF 25V TH | 10µF 25V Aluminum Electrolytic Capacitors Radial Lead Type TH, Dia-5mm, Pitch-2mm ECEA1EN100UI
2 | C2, C4, C5 | 3 | CAP 0.1uF 100V 0805 | Samsung | CL21B104KCFNNNE | CAP CER 0.1uF/50V 5% | CAP CER 0.1uF/100V Ceramic Capacitor X7R 0805 (2012 Metric) SMT
3 | C3 | 1 | CAP ELE 100uF 16V TH | Panasonic | ECA-1CM101 | CAP ELE 10µF 25V TH | 100uF 16V Aluminum Electrolytic Capacitor Radial TH, Dia-5mm x 11mm (Panasonic M series)
4 | C6 | 1 | TANT CAP 10uF/16V 10% 3528(B) | AVX | TAJB106K016RNJ | TANT CAP 3528(B) | 10 µF Molded Tantalum Capacitor 16V 10% 1411 (3528 Metric), 1210 TAJB106K016RNJ
5 | C7 | 1 | 10uF | Murata | GRM31CR71C106KAC7L | CAPC3216X175N | 10 µF ±10% 16V Ceramic Capacitor X7R 1206 (3216 Metric)
6 | C8 | 1 | 100nF | KEMET | C1206C104K5RACTU | CAPC3216X175N | 0.1 µF ±10% 50V Ceramic Capacitor X7R 1206 (3216 Metric)
7 | C9 | 1 | 1uF | KEMET | C1206C105K5RACTU | CAPC3216X175N | 1 µF ±10% 50V Ceramic Capacitor X7R 1206 (3216 Metric)
8 | C10, C17, C18, C19, C20, C21, C22, C24, C35, C36 | 10 | 0.1uf | Samsung | CL21B104KCFNNNE | CAPC2012X140N | 0.1 ÂµF Â±10% 100V Ceramic Capacitor X7R 0805 (2012 Metric)
9 | C11, C13 | 2 | 1nF |  | C0805C102F3HACAUTO | CAP 0805_2012 | CAP CER 0805 1NF 25V ULTRA STABL
10 | C12, C14, C15 | 3 | 100nF |  | CL21B104KCFNNNE | CAP 0805_2012 | CAP CER 0805 0.1UF 100V X7R
11 | C16 | 1 | 0.1uF X2 275VAC |  | ECQUAAF104M | CAPRR1500W60L1750T500H1200 | Film Capacitor X2 0.1uF 275VAC 15mm pitch
12 | C23, C25 | 2 | 10uF | Samsung | CL21A106KOQNNNE | CAPC2012X140N | 0.1 ÂµF Â±10% 100V Ceramic Capacitor X7R 0805 (2012 Metric)
13 | C26 | 1 | 4.7uF | Samsung | CL21A475KAQNNNE | CAPC2012X140N | 0.1 ÂµF Â±10% 100V Ceramic Capacitor X7R 0805 (2012 Metric)
14 | C27, C29 | 2 | 10nF | Samsung | CL21B103KBANNNC | CAPC2012X140N | 0.1 ÂµF Â±10% 100V Ceramic Capacitor X7R 0805 (2012 Metric)
15 | C28 | 1 | 22nF | Samsung | CL21B223KBANNNC | CAPC2012X140N | 0.1 ÂµF Â±10% 100V Ceramic Capacitor X7R 0805 (2012 Metric)
16 | C30, C31 | 2 | 6.8nF | Samsung | CL21B682KBANNNC | CAPC2012X140N | 0.1 ÂµF Â±10% 100V Ceramic Capacitor X7R 0805 (2012 Metric)
17 | C32, C33 | 2 | 27pF | Samsung | CL21C270JBANNNC | CAPC2012X140N | 0.1 ÂµF Â±10% 100V Ceramic Capacitor X7R 0805 (2012 Metric)
18 | C34 | 1 | 1nF 2kV | KEMET | C1206C102KGRACAUTO | CAPC3216X175N | 1000 pF Â±10% 2000V (2kV) Ceramic Capacitor X7R 1206 (3216 Metric)
19 | D1, D2, D8 | 3 | 597-3305-607F |  | 597-3305-607F | LEDC2012X70N | LED Uni-Color Green 4-Pin Chip 0805 T/R
20 | D3, D4, D6 | 3 | SMAJ7.5CA |  | SMAJ7.5CA | DIOM4325X250N
21 | D5, D9, D11, D12, D13, D15 | 6 | LL4148_L1G |  | LL4148_L1G | DIOMELF3515N
22 | D7 | 1 | SMAJ5.0A |  | SMAJ5.0A | DIOM4325X250N | TVS diode unidirectional 5V standoff 400W SMA (DO-214AC); pin 1 = cathode
23 | D10, D14, D16 | 3 | APT2012SRCPRV | Kingbright | APT2012SRCPRV | LEDC2012X75N | Red 640nm LED Indication - Discrete 1.85V 0805 (2012 Metric)
24 | F1, F2 | 2 | MF-MSMF010-2 | Bourns | MF-MSMF010-2 | FUSER_MF-MSMF010-2 | Polymeric PTC Resettable Fuse 60V 100 mA Ih Surface Mount 1812 (4532 Metric), Concave
25 | F3 | 1 | T1A 250V | Taiyo Yuden | TR5 | TR5 | Fuse TR5 1A Time-Lag 250VAC (Littelfuse 372 series)
26 | FB1 | 1 | FB 1k@100MHz |  | MPZ2012S102AT000 | BEADC2012X105N
27 | J1 | 1 | TB007-508-02BE | Same Sky | TB007-508-02BE | CUI_TB007-508-02BE | 2~24 Poles, Screw Type, Horizontal, 5.08 Pitch, 24~12 (AWG), Terminal Block Connector
28 | J2 | 1 | 68604-406HLF | AMPHENOL ICC / FCI | 68604-406HLF | AMPHENOL_68604-406HLF | BergStik, Board to Board connector, Unshrouded Vertical Header, Through Hole, Single Row, 6 Positions, 2.54 mm (0.100in) Pitch.
29 | J3 | 1 | TSS-108-01-T-D |  | TSS-108-01-T-D | SAMTEC_TSS-108-01-T-D
30 | J4 | 1 | 284513-3 | TE Connectivity | 284513-3 | TE_284513-3 | 3 Position 3.81 mm Pitch Green Right Angle Through Hole Terminal Block Header
31 | J5 | 1 | TBP02R1-381-02BE | Same Sky (CUI) | TBP02R1-381-02BE | CUI_TBP02R138102BE | Terminal block header 2-pos 3.81 mm, right angle (mating plug TBP01P1-381-02BE)
32 | J6, J7, J8, J10, J11 | 5 | RELAY OUT | WÃ¼rth Elektronik | 691236510003 | 691236510003 | 3 Position Wire to Board Terminal Block Horizontal with Board 0.200 (5.08mm) Through Hole
33 | J9 | 1 | HR911105A | hanrun | HR911105A | HANRUN_HR911105A | DIP RJ45 Connector;
34 | JP1, JP2 | 2 | NO/NC SEL |  | 68001-403HLF | AMPHENOL_68001-403HLF
35 | K1, K2, K3 | 3 | SRD-05VDC-SL-C | Songle Relay | SRD-05VDC-SL-C | RELAY_SRD-03VDC-SL-C | Relays General Purpose Non Latching 3VDC SPDT 10A (250VAC) Max 5PIN
36 | PS1 | 1 | HLK-10M05 | Hi-link | HLK-10M05 | CONV_HLK-10M05 | 10W Ultra-Compact Power Module
37 | PS2 | 1 | RFM-0505S SIP4 | Recom Power | RFM-0505S | RFM-0505S | DC-DC Converter/Isolator, SIP4, 1kV unreg, Single Output, 1W, 5V Out, RFM Series RECOM Power Inc. RFM-0505S
38 | Q1, Q2, Q4, Q5, Q6 | 5 | BC848C_RFG | Taiwan Semiconductor | BC848C RFG | SOT95P237X112-3N | SOT-23, 30V, 0.1A, NPN Transistor
39 | Q3 | 1 | SI2301 | Vishay | SI2301CDS-T1-GE3 | DESTO_SOT23 | P-MOSFET 20V 2.3A SOT-23, reverse-polarity protection for 5V DC input
40 | R1, R2, R3, R14, R18, R19, R20, R21, R22, R32, R35 | 11 | 10k |  | ERA6VRB1002V | RES_ERA6VRB1002V
41 | R4, R10 | 2 | 330 Ohms | Vishay Dale | CRCW0805330RFKEAHP | RES 0805_2012 | RES SMD 330 OHM 1% 1/2W 0805
42 | R5, R9 | 2 | 330 Ohms | YAGEO | RC0805FR-07330RL | RES 0805_2012 | RES SMD 330 OHM 1% 1/8W 0805
43 | R6, R11 | 2 | 10 kOhms | TE Connectivity Passive Product | CPF0805B10KE | RES 0805_2012 | RES SMD 10K OHM 0.1% 1/10W 0805
44 | R7 | 1 | 120 Ohms | YAGEO | RC0805FR-07120RL | RES 0805_2012 | RES SMD 120 OHM 1% 1/8W 0805
45 | R8 | 1 | 1 kOhms | TE Connectivity Passive Product | CPF0805B1K0E | RES 0805_2012 | RES SMD 1K OHM 0.1% 1/10W 0805
46 | R12 | 1 | 150 Ohms | Vishay Dale | CRCW0805150RFKEAHP | RES 0805_2012 | RES SMD 150 OHM 1% 1/2W 0805
47 | R13, R15, R16, R17, R31, R33, R34, R36 | 8 | 1k |  | ERA6VRB1001V | RES_ERA6VRB1002V
48 | R23 | 1 | 12.4k 1% |  | ERJ-6ENF1242V | RES_ERA6VRB1002V
49 | R24, R25, R26, R27 | 4 | 49.9R 1% |  | ERJ-6ENF49R9V | RES_ERA6VRB1002V
50 | R28 | 1 | 10R |  | ERJ-6ENF10R0V | RES_ERA6VRB1002V
51 | R29, R30 | 2 | 330R |  | ERJ-6ENF3300V | RES_ERA6VRB1002V
52 | R37, R38 | 2 | 4.7k |  | ERA6VRB4701V | RES_ERA6VRB1002V
53 | R39, R40, R41, R42 | 4 | 47 Ohms | YAGEO | RC0805FR-0747RL | RES 0805_2012 | RES SMD 47 OHM 1% 1/8W 0805
54 | RT1 | 1 | 5R NTC | EPCOS - TDK Electronics | B57236S0509M000 | THRMRB500W60L1150T500H1600 | NTC Inrush Current Limiter 5 Ohm 20% 4.5A 11.5mm
55 | RV1 | 1 | 14D471K | HuaXingAn Electronics | MOV-14D471K | MOV14D471K | Varistor 14mm 470V (300VAC)
56 | U1 | 1 | ESP32-WROOM-32 | Espressif Systems | ESP32-WROOM-32 | MODULE_ESP32-WROOM-32 | Bluetooth, WiFi 802.11b/g/n, Bluetooth v4.2 +EDR, Class 1, 2 and 3 Transceiver Module 2.4GHz ~ 2.5GHz Antenna Not Included, U.FL Surface Mount
57 | U2 | 1 | 74HC14D | Toshiba | 74HC14D | SOIC127P600X175-14N | Inverter IC 6 Channel Schmitt Trigger 14-SOIC
58 | U3 | 1 | SN65176BDR | Texas Instruments | SN65176BDR | SOIC127P599X175-8N | Differential Bus Transceiver
59 | U4 | 1 | ADUM1201CR | Analog Devices | ADUM1201CR | SOIC127P600X175-8N | General Purpose Digital Isolator 2500Vrms 2 Channel 25Mbps 8-SOIC
60 | U5, U6 | 2 | EL817S1 | {'manufacturer': u'Everlight Electronics Co Ltd'} | EL817S1(A)(TU)-V | SOIC254P1030X390-4N_EL817S1(A)(TU)-V | Optoisoltr 5kv Transistor 4-Smd
61 | U7 | 1 | W5500 |  | W5500 | QFP50P900X900X160-48N | Hardwired TCP/IP embedded Ethernet controller
62 | U8 | 1 | AT24C512C-SSHM-T | Microchip | AT24C512C-SSHM-T | SOIC127P600X175-8N | EEPROM Memory IC 512Kb (64K x 8) IÂ²C 400 kHz 900 ns 8-SOIC
63 | VR1 | 1 | LM1117IMPX-3.3V SOT-223 | Texas Instruments | LM1117IMPX-3.3/NOPB | LM1117IMPX-3.3V SOT-223 | LM1117IMPX-3.3V 800-mA 15-V linear voltage regulator SOT-223
64 | Y1 | 1 | 25MHz 18pF | Fox Electronics | ECS-250-18-5PX-TR | XTAL1170X500X450 | 12.288 MHz Â±30ppm Crystal 20pF 60 Ohms HC-49/US
