sudodevjay/esp32p10display/Order_Files/BOM_JLCPCB.csv

Comment | Designator | Footprint | LCSC Part #
CAP ELE 10µF 25V TH | C1 | CAP ELE 10µF 25V TH
CAP 0.1uF 100V 0805 | C2,C4,C5 | CAP CER 0.1uF/50V 5%
CAP ELE 100uF 16V TH | C3 | CAP ELE 10µF 25V TH
TANT CAP 10uF/16V 10% 3528(B) | C6 | TANT CAP 3528(B)
10uF | C7 | CAPC3216X175N
100nF | C8 | CAPC3216X175N
1uF | C9 | CAPC3216X175N
0.1uf | C10,C17,C18,C19,C20,C21,C22,C24,C35,C36 | CAPC2012X140N
1nF | C11,C13 | CAP 0805_2012
100nF | C12,C14,C15 | CAP 0805_2012
0.1uF X2 275VAC | C16 | CAPRR1500W60L1750T500H1200
10uF | C23,C25 | CAPC2012X140N
4.7uF | C26 | CAPC2012X140N
10nF | C27,C29 | CAPC2012X140N
22nF | C28 | CAPC2012X140N
6.8nF | C30,C31 | CAPC2012X140N
27pF | C32,C33 | CAPC2012X140N
1nF 2kV | C34 | CAPC3216X175N
597-3305-607F | D1,D2,D8 | LEDC2012X70N
SMAJ7.5CA | D3,D4,D6 | DIOM4325X250N
LL4148_L1G | D5,D9,D11,D12,D13,D15 | DIOMELF3515N
SMAJ5.0A | D7 | DIOM4325X250N
APT2012SRCPRV | D10,D14,D16 | LEDC2012X75N
MF-MSMF010-2 | F1,F2 | FUSER_MF-MSMF010-2
T1A 250V | F3 | TR5
FB 1k@100MHz | FB1 | BEADC2012X105N
TB007-508-02BE | J1 | CUI_TB007-508-02BE
68604-406HLF | J2 | AMPHENOL_68604-406HLF
TSS-108-01-T-D | J3 | SAMTEC_TSS-108-01-T-D
284513-3 | J4 | TE_284513-3
TBP02R1-381-02BE | J5 | CUI_TBP02R138102BE
RELAY OUT | J6,J7,J8,J10,J11 | 691236510003
HR911105A | J9 | HANRUN_HR911105A
NO/NC SEL | JP1,JP2 | AMPHENOL_68001-403HLF
SRD-05VDC-SL-C | K1,K2,K3 | RELAY_SRD-03VDC-SL-C
HLK-10M05 | PS1 | CONV_HLK-10M05
RFM-0505S SIP4 | PS2 | RFM-0505S
BC848C_RFG | Q1,Q2,Q4,Q5,Q6 | SOT95P237X112-3N
SI2301 | Q3 | DESTO_SOT23
10k | R1,R2,R3,R14,R18,R19,R20,R21,R22,R32,R35 | RES_ERA6VRB1002V
330 Ohms | R4,R10 | RES 0805_2012
330 Ohms | R5,R9 | RES 0805_2012
10 kOhms | R6,R11 | RES 0805_2012
120 Ohms | R7 | RES 0805_2012
1 kOhms | R8 | RES 0805_2012
150 Ohms | R12 | RES 0805_2012
1k | R13,R15,R16,R17,R31,R33,R34,R36 | RES_ERA6VRB1002V
12.4k 1% | R23 | RES_ERA6VRB1002V
49.9R 1% | R24,R25,R26,R27 | RES_ERA6VRB1002V
10R | R28 | RES_ERA6VRB1002V
330R | R29,R30 | RES_ERA6VRB1002V
4.7k | R37,R38 | RES_ERA6VRB1002V
47 Ohms | R39,R40,R41,R42 | RES 0805_2012
5R NTC | RT1 | THRMRB500W60L1150T500H1600
14D471K | RV1 | MOV14D471K
ESP32-WROOM-32 | U1 | MODULE_ESP32-WROOM-32
74HC14D | U2 | SOIC127P600X175-14N
SN65176BDR | U3 | SOIC127P599X175-8N
ADUM1201CR | U4 | SOIC127P600X175-8N
EL817S1 | U5,U6 | SOIC254P1030X390-4N_EL817S1(A)(TU)-V
W5500 | U7 | QFP50P900X900X160-48N
AT24C512C-SSHM-T | U8 | SOIC127P600X175-8N
LM1117IMPX-3.3V SOT-223 | VR1 | LM1117IMPX-3.3V SOT-223
25MHz 18pF | Y1 | XTAL1170X500X450
