sudodevjay/esp32p10display/(list of files, drawings)

Other design files:
esp32p10displayPCB1.PcbDoc
esp32p10displayProject.PrjPcb
esp32p10displaySheet1.SchDoc
esp32p10displaySheet2.SchDoc
esp32p10displaySheet3.SchDoc
esp32p10displaySheet4.SchDoc
