sudodevjay/esp32p10display/(commit log)

2026-10-14 ESP32 P10 display controller: Altium project, Gerber, BOM
2026-10-19 Add W5500 Ethernet, relay and opto inputs; review fixes
    - Ethernet: W5500 + HR911105A on new Sheet3, board extended to 95.5 x 140.8 mm,
    placed and routed (SCLK moved to IO2), GND pour repaired, designators placed
    - U2 74HC14 unused input 1A tied to ISO_5V (was floating)
    - VR1 LM1117 heatsink copper: top/bottom 3V3 fills with 18 thermal vias
    - Rules: min width 6 mil, Clearance_U7 8 mil for the 0.5 mm pitch W5500
    - Altium DRC: 0 electrical violations; ERC 0 errors
    - New Gerber 2026-10-19, BOM + JLCPCB BOM/CPL, renders, ngspice simulation plots
    - Removed stale outputs, local libraries and images; README updated
2026-10-20 Add relays K2/K3, AT24C512 EEPROM; board grows to 95.5 x 153.5 mm
    - New Sheet4: K2/K3 relay blocks (copies of K1: SRD-05VDC, BC848C, LL4148,
    red LED, 3-pin terminals J10/J11) and U8 AT24C512C-SSHM-T with 4.7k
    pull-ups and 100nF
    - GPIO: RELAY2 = IO12 (pull-down keeps the strapping pin low at boot),
    RELAY3 = IO22, I2C SDA = IO25, SCL = IO15; IO21 is free
    - W5500 reset no longer on a GPIO: R22 10k + C35 100nF RC on RSTn
    - PCB: K2/K3 stacked under K1 at 650 mil pitch, drivers in the left strip,
    inputs/optos moved into the new bottom area; board extended 500 mil
    down (rectangle), RJ45 J9 and J7/J8 on the new bottom edge, whole design
    shifted +500 mil so the origin is the bottom-left c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
2026-10-23 Series 47R on all W5500 SPI lines, RS485 bias 470R
    - R39-R42 (47R 0805) in series with SCLK, MISO, MOSI, CS; MOSI/CS re-routed
    (ISO 60 mil / mains 240 mil respected), R20 pull-up stays on the W5500 side
    - RS485 bias resistors R5/R9 1k -> 470R (idle Vab 0.55 V, works with 2 terminators)
    - Sheet1/Sheet3 updated (ESP_* nets on the ESP32 side), Altium DRC 45 (baseline), ERC 0 errors
    - Outputs regenerated 2026-10-23: Gerber zip, BOM, JLCPCB BOM + CPL, renders
    - autotool.json: RLY2/RLY3 nets added to the MAINS class; README updated
2026-10-23 Add project libraries so a clone opens exactly like the original
    - Libraries/: the 37 IntLib/SchLib/PcbLib files this design uses (21 MB), attached to the
    PrjPcb as project libraries; the external ..\bluetooth_controller path now points here
    - PrjPcb: removed the stale "Design Rule Check .html" entry (file no longer exists)
    - README: how to open the project on another computer
    - Add the Excel purchase list and the sourcing report; BOM/CPL regenerated
2026-10-23 Add Order_Files/ with Gerber, BOM, CPL, Excel purchase list and board renders in one place
2026-10-23 RS485: on-board 120R terminator (R7) and 330R bias (R5/R9)
    - R7 (between A and B) 10k -> 120R, R5/R9 470R -> 330R; '1' level 0.39 V with a second terminator
    at the far end (24/24 bits at 38400 baud), no external resistor needed
    - BOM, JLCPCB BOM, Gerber, Excel purchase list and Order_Files regenerated
2026-10-23 Purchase list reduced to the P10-display-only build (PCB unchanged)
2026-10-23 Purchase list: external 5V SMPS, so no AC mains parts (HLK-10M05, MOV, fuse, NTC, X2 cap, J1)
2026-10-23 Order_Files: remove stale duplicate CSVs, keep single Component_Order_List.xlsx (P10-only, external 5V)
2026-10-23 Order list: add parts not on Sharvi/Robu (ESP32, C3, C6, C8, J5)
